bruinformula/mk11-can-sniffer-pcb/CAN_Sniffer_V2_/ECAD/CLF5030NIT-101M-D.step

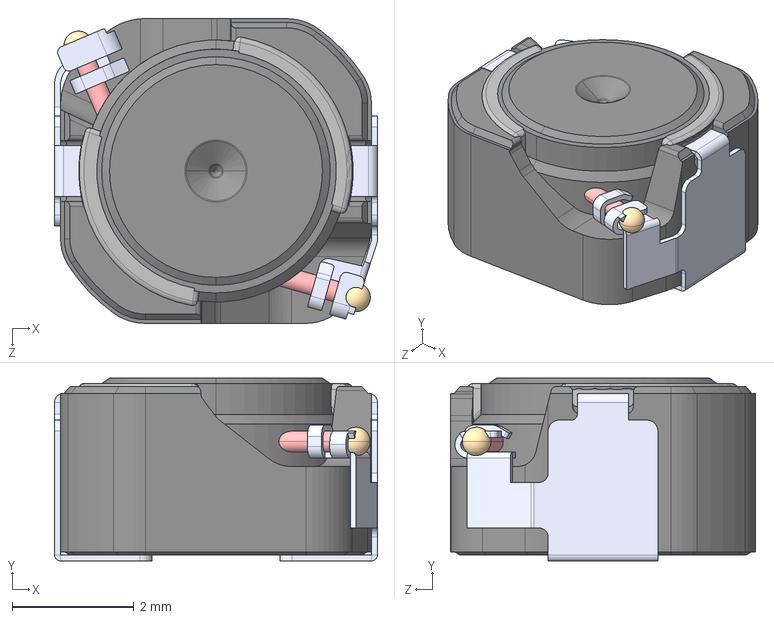
[picture p1: CAD file, 2026-01-09]
CAN_Sniffer_V2_/ECAD/CLF5030NIT-101M-D.step
5.30 x 3.00 x 5.00 mm
