bruinformula/mk11-can-sniffer-pcb/CAN_Sniffer_V2_/ECAD/DDZ13B-7.stp

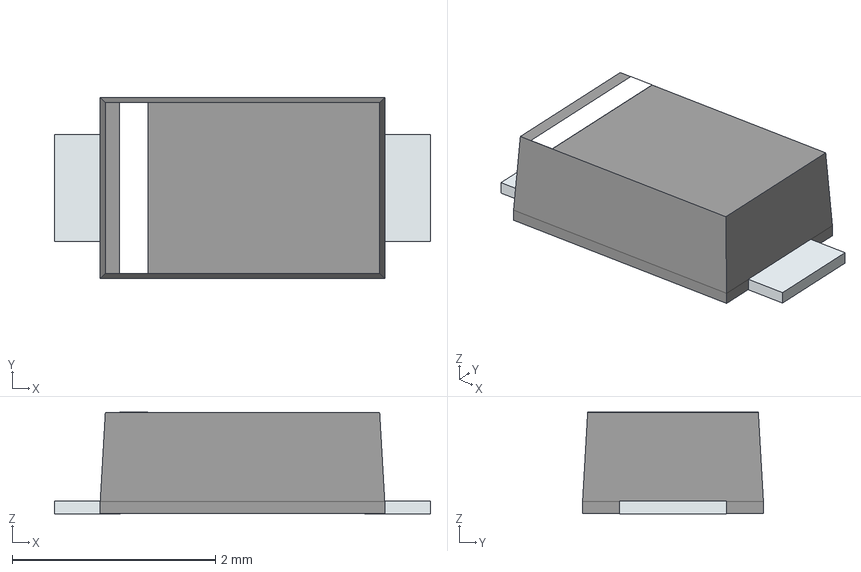
[picture p2: CAD file, 2025-09-27]
CAN_Sniffer_V2_/ECAD/DDZ13B-7.stp
3.70 x 1.78 x 1.00 mm
PinKIdent
PinK
PinA
