bruinformula/mk11-can-sniffer-pcb/CAN_Sniffer_V2_/ECAD/SQ2319CES-T1_GE3.stp

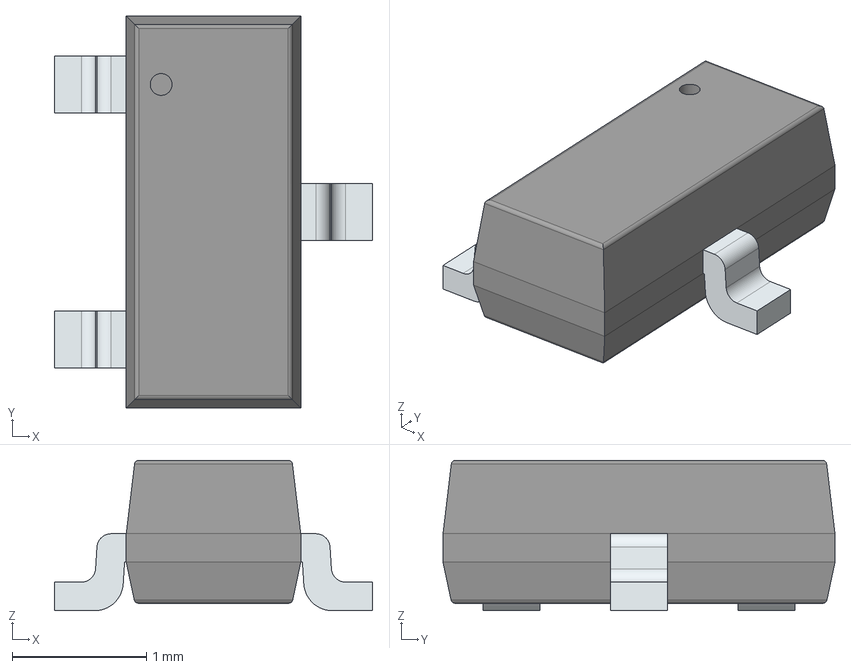
[picture p3: CAD file, 2025-09-27]
CAN_Sniffer_V2_/ECAD/SQ2319CES-T1_GE3.stp
2.37 x 2.92 x 1.12 mm
PinsArrayL
FilletPinR
