bruinformula/mk11-can-sniffer-pcb/CAN_Sniffer_V2_/ECAD/TPS2121RUXR.stp

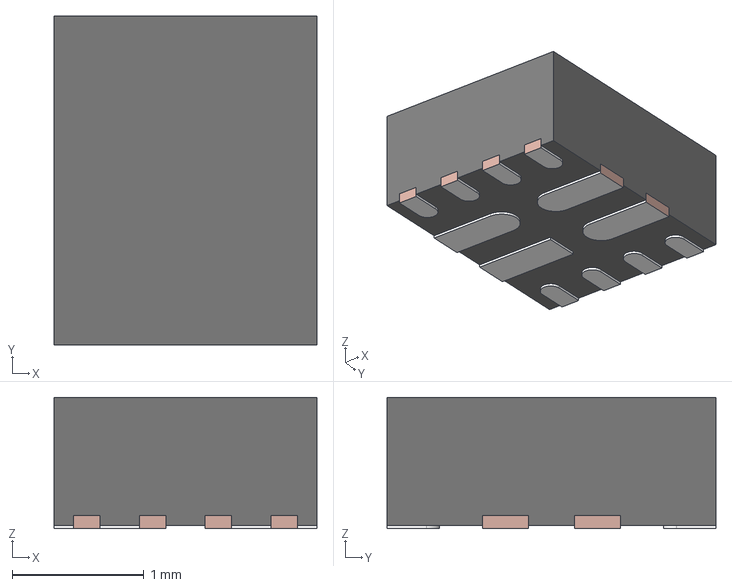
[picture p4: CAD file, 2025-09-27]
CAN_Sniffer_V2_/ECAD/TPS2121RUXR.stp
2.00 x 2.50 x 1.00 mm
FRAME
MOLD
