bruinformula/mk11-can-sniffer-pcb/CAN_Sniffer_V2_/ECAD/CLF7045NIT-330M-D.step

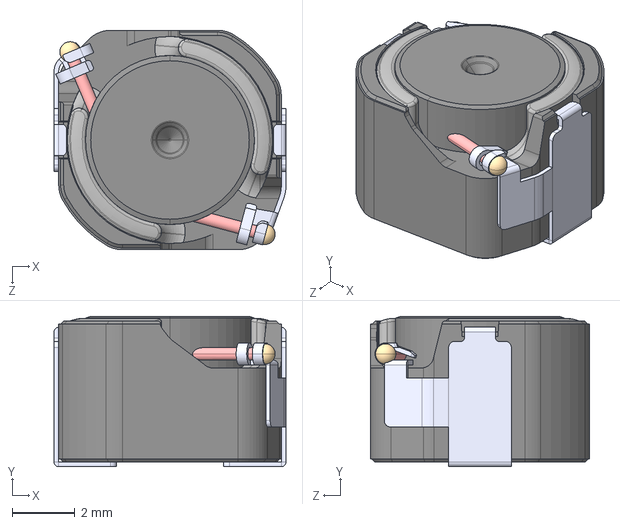
[picture p5: CAD file, 2025-09-27]
CAN_Sniffer_V2_/ECAD/CLF7045NIT-330M-D.step
7.40 x 4.80 x 7.00 mm
