bruinformula/mk11-can-sniffer-pcb/CAN_Sniffer_V2_/ECAD/PD3S230LQ-7.stp

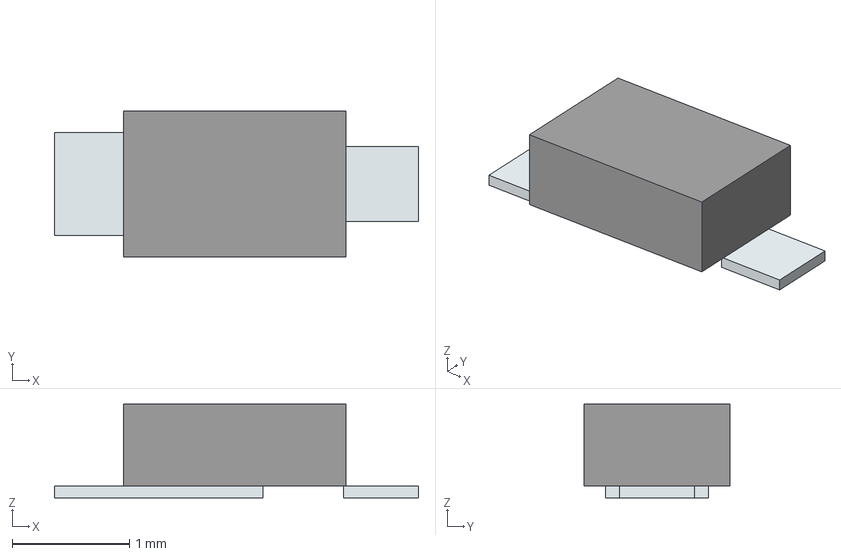
[picture p6: CAD file, 2025-09-27]
CAN_Sniffer_V2_/ECAD/PD3S230LQ-7.stp
3.11 x 1.25 x 0.8 mm
Pins
