bruinformula/mk11-can-sniffer-pcb/CAN_Sniffer_V2_/ECAD/DDA0008J.stp

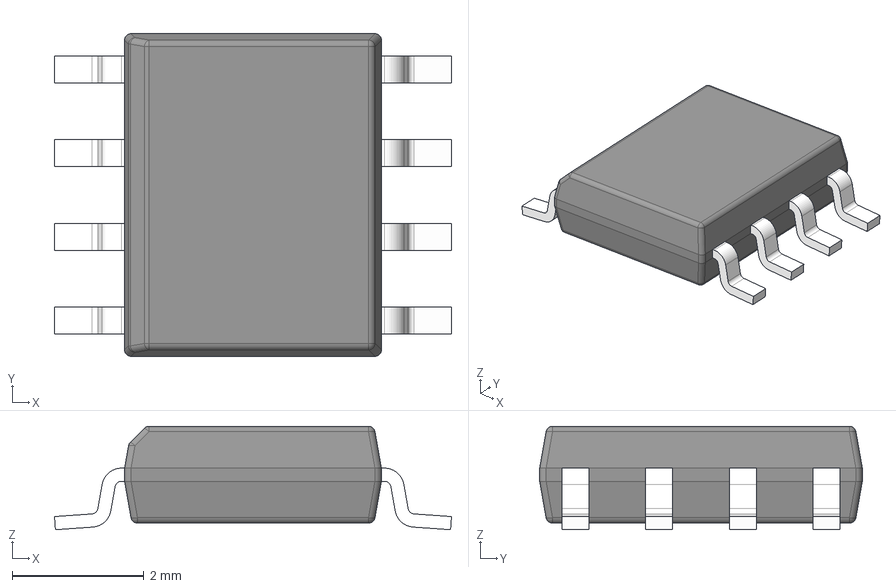
[picture p7: CAD file, 2025-09-27]
CAN_Sniffer_V2_/ECAD/DDA0008J.stp
6.03 x 4.90 x 1.57 mm
BODY-SO
LEAD-SO x 8
THERMALPAD-SO
