bruinformula/mk11-can-sniffer-pcb/CAN_Sniffer_V2_/ECAD/TPD2E001DZDR.stp

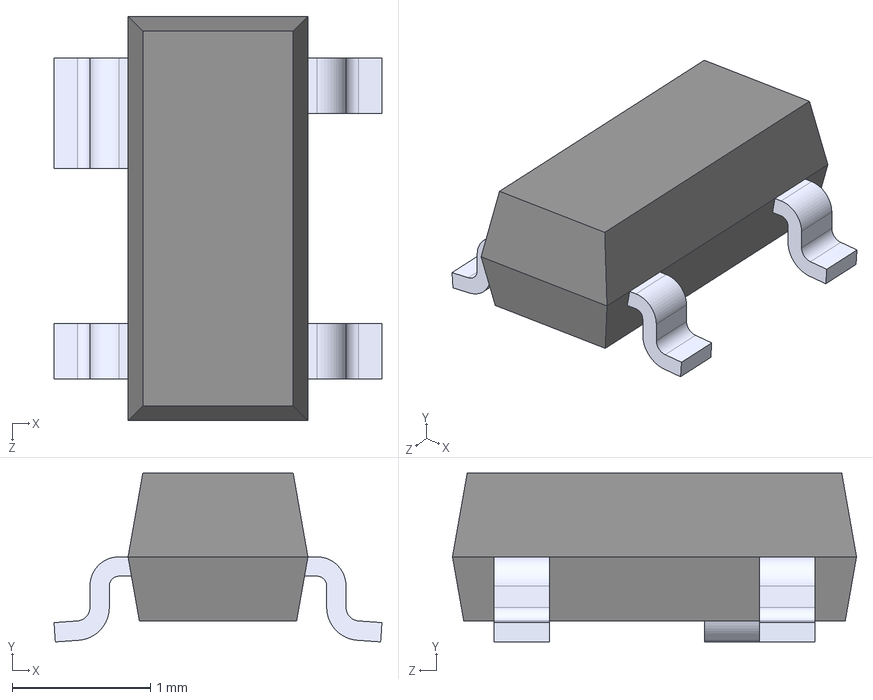
[picture p8: CAD file, 2025-09-27]
CAN_Sniffer_V2_/ECAD/TPD2E001DZDR.stp
2.37 x 1.22 x 2.92 mm
