bruinformula/mk11-can-sniffer-pcb/CAN_Sniffer_V2_/ECAD/USB1125-GF-B.stp

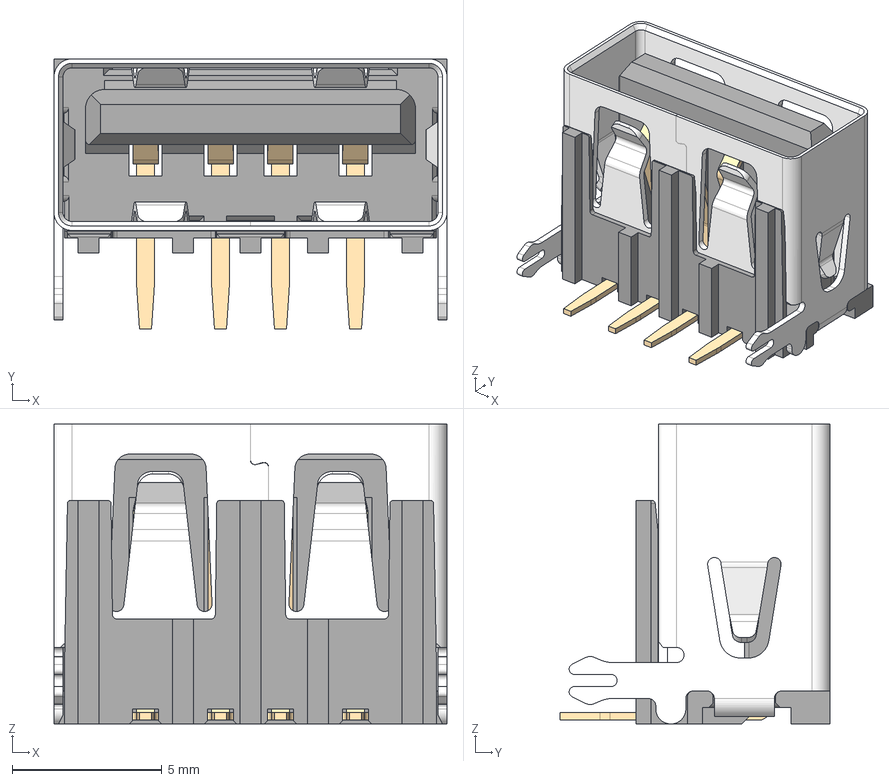
[picture p9: CAD file, 2025-09-27]
CAN_Sniffer_V2_/ECAD/USB1125-GF-B.stp
13.1 x 9.01 x 10.0 mm
USB1125-GF-B_PART1 x 4
USB1125-GF-B_PART2
USB1125-GF-B_PART3
