bruinformula/mk11-can-sniffer-pcb/CAN_Sniffer_V1/ECAD/693072010801.stp

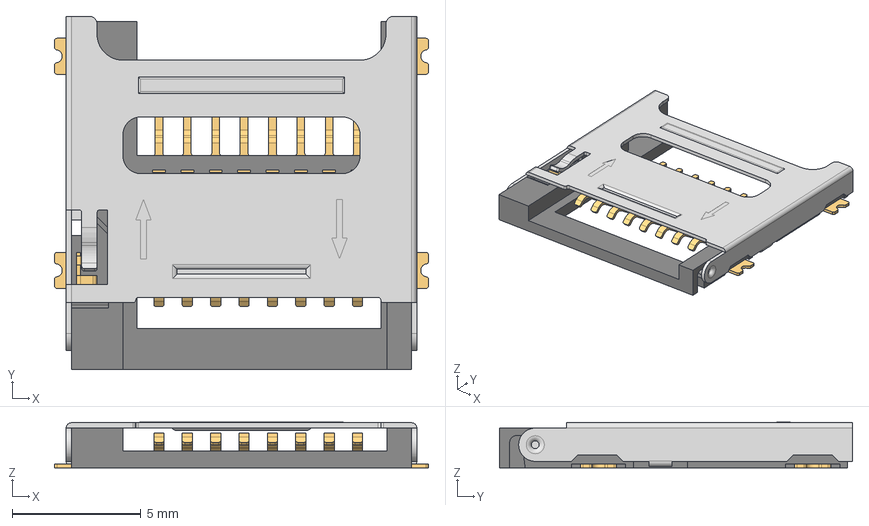
[picture p10: CAD file, 2026-01-09]
CAN_Sniffer_V1/ECAD/693072010801.stp
14.5 x 13.7 x 1.77 mm
693072010801_PIN x 8
693072010801_PATTE x 3
693072010801_CACHE
693072010801_PATTE_SPE
