bruinformula/mk11-can-sniffer-pcb/CAN_Sniffer_V1/CAN_Sniffer_1.0.kicad_pcb

## KiCad design CAN_Sniffer_V1/CAN_Sniffer_1.0.kicad_pcb (2026-01-09)

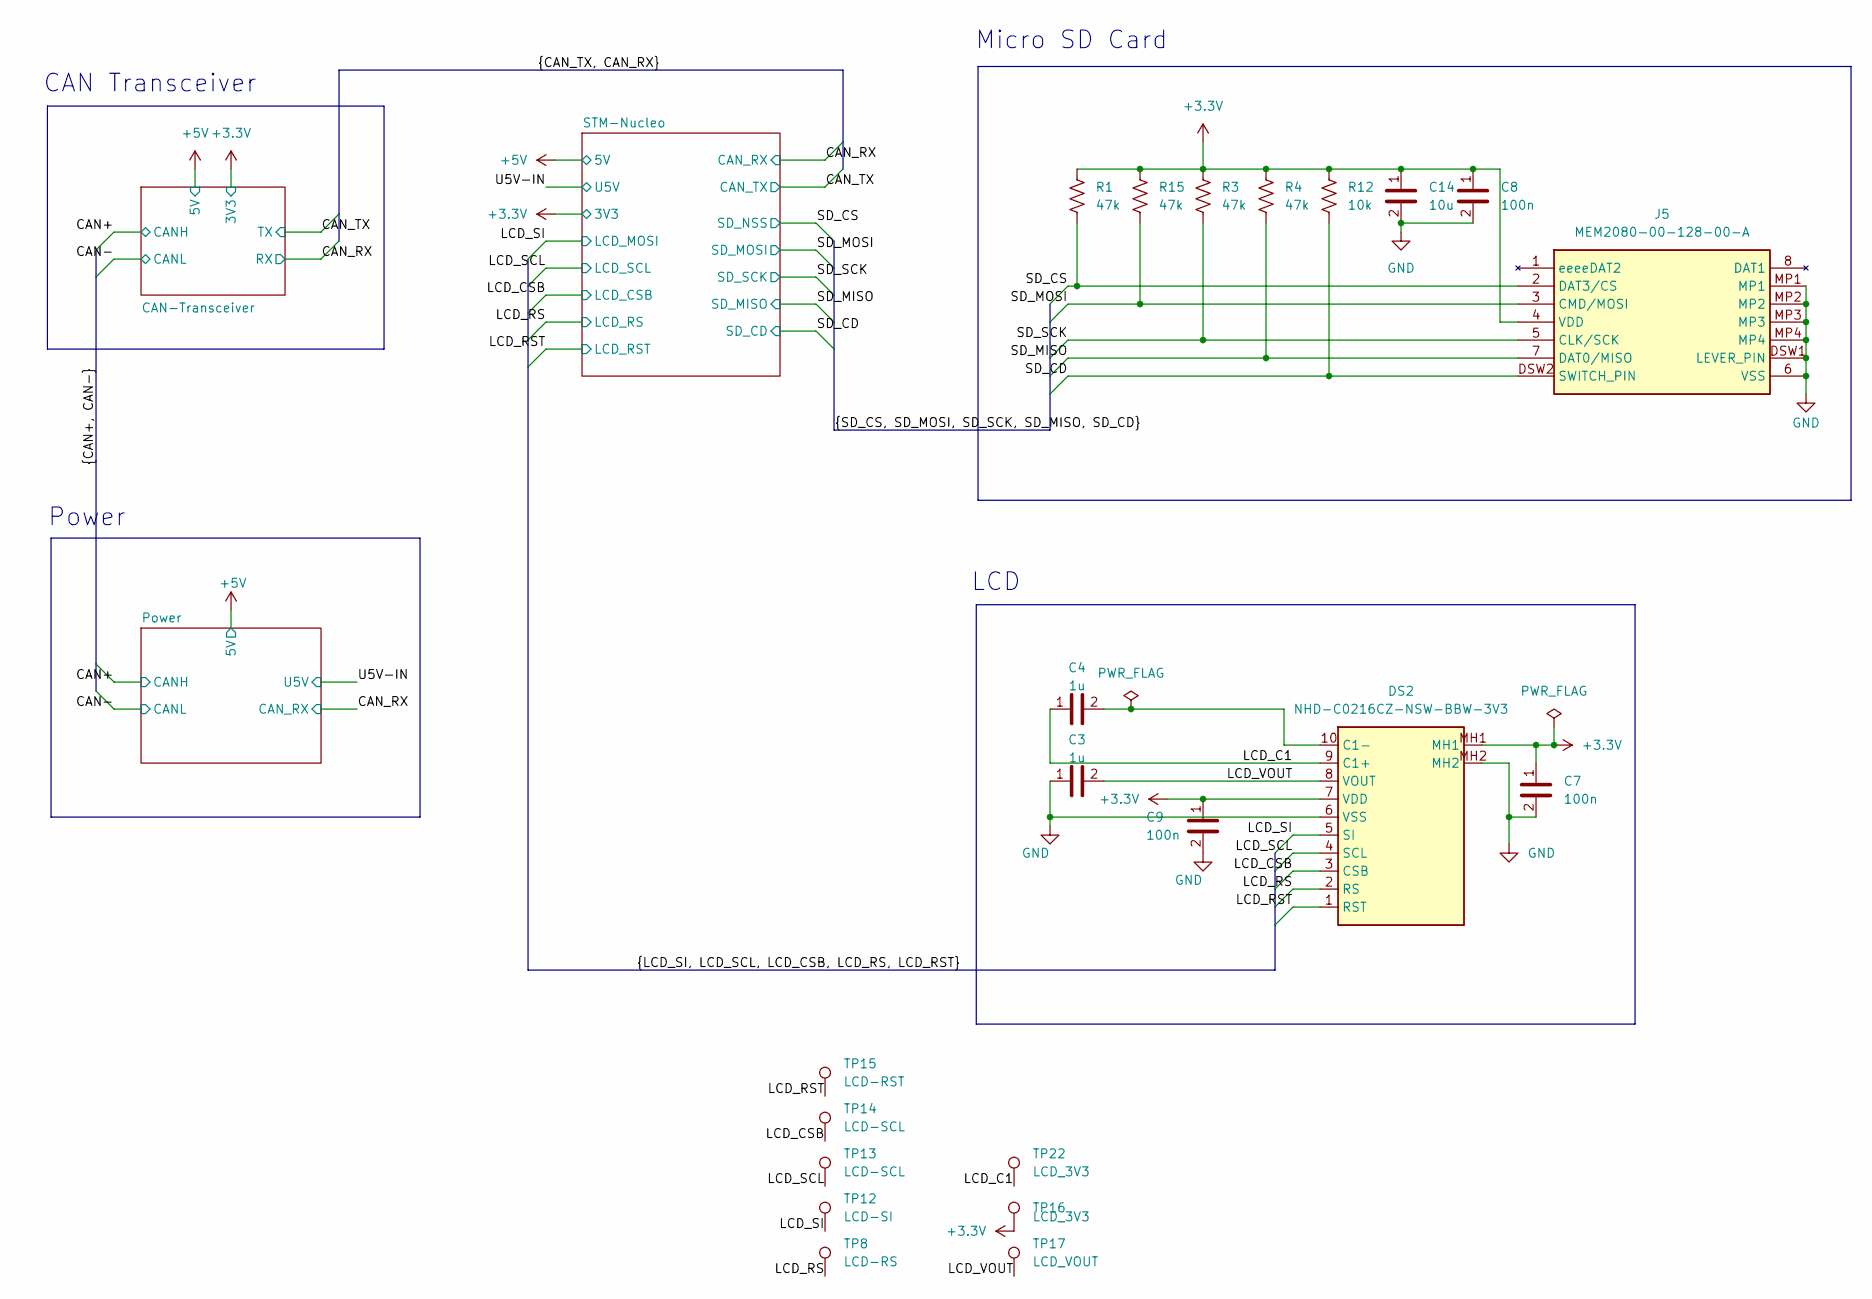
[picture p11: schematic CAN_Sniffer_1.0.kicad_sch]

Parts:
C3, C4: 1u; C_0603_1608Metric_Pad1.08x0.95mm_HandSolder; Mouser P/N 963-MAJCT168BB7105KT
C7, C8, C9: 100n; C_0603_1608Metric_Pad1.08x0.95mm_HandSolder; Mouser P/N 581-06035C104KAT2A; Digikey P/N 478-KGM15BR71H104KTCT-ND
C14: 10u; C_0603_1608Metric_Pad1.08x0.95mm_HandSolder; Mouser P/N 81-GRM188R61E106MA3D
DS2: NHD-C0216CZ-NSW-BBW-3V3; NHDC0216CZNSWBBW3V3; Mouser Part Number 763-C0216CZ-NSWBBW3V
J5: MEM2080-00-128-00-A; MEM20800012800A; Mouser Part Number 640-MEM2080-0012800A
R1, R3, R4, R15: 47k; R_0603_1608Metric_Pad0.98x0.95mm_HandSolder; Mouser P/N 708-RMCF0603FT47K0; Digikey P/N RMCF0603FT47K0CT-ND
R12: 10k; R_0603_1608Metric_Pad0.98x0.95mm_HandSolder; Mouser P/N 708-RMCF0603FT10K0; Digikey P/N RMCF0603FT10K0CT-ND
TP8: LCD-RS; TestPoint_Pad_D1.0mm
TP12: LCD-SI; TestPoint_Pad_D1.0mm
TP13, TP14: LCD-SCL; TestPoint_Pad_D1.0mm
TP15: LCD-RST; TestPoint_Pad_D1.0mm
TP16, TP22: LCD_3V3; TestPoint_Pad_D1.0mm
TP17: LCD_VOUT; TestPoint_Pad_D1.0mm

Connections:
+3.3V: C7.1, C8.1, C9.1, C14.1, DS2.7 (VDD), DS2.MH1, J5.4 (VDD), R1.2, R3.2, R4.2, R12.2, R15.2, TP16.1; also elsewhere on the board
/LCD_C1: C4.1, DS2.9 (C1+), TP22.1
/LCD_CSB: DS2.3 (CSB), TP14.1; also elsewhere on the board
/LCD_RS: DS2.2 (RS), TP8.1; also elsewhere on the board
/LCD_RST: DS2.1 (RST), TP15.1; also elsewhere on the board
/LCD_SCL: DS2.4 (SCL), TP13.1; also elsewhere on the board
/LCD_SI: DS2.5 (SI), TP12.1; also elsewhere on the board
/LCD_VOUT: C3.2, DS2.8 (VOUT), TP17.1
/SD_CD: J5.DSW2 (SWITCH_PIN), R12.1; also elsewhere on the board
/SD_CS: J5.2 (DAT3/CS), R1.1; also elsewhere on the board
/SD_MISO: J5.7 (DAT0/MISO), R4.1; also elsewhere on the board
/SD_MOSI: J5.3 (CMD/MOSI), R15.1; also elsewhere on the board
/SD_SCK: J5.5 (CLK/SCK), R3.1; also elsewhere on the board
GND: C3.1, C7.2, C8.2, C9.2, C14.2, DS2.6 (VSS), DS2.MH2, J5.6 (VSS), J5.DSW1 (LEVER_PIN), J5.MP1, J5.MP2, J5.MP3, J5.MP4; also elsewhere on the board
unnamed: C4.2, DS2.10 (C1-)

Notes on the sheet:
LCD
Power
Micro SD Card
CAN Transceiver

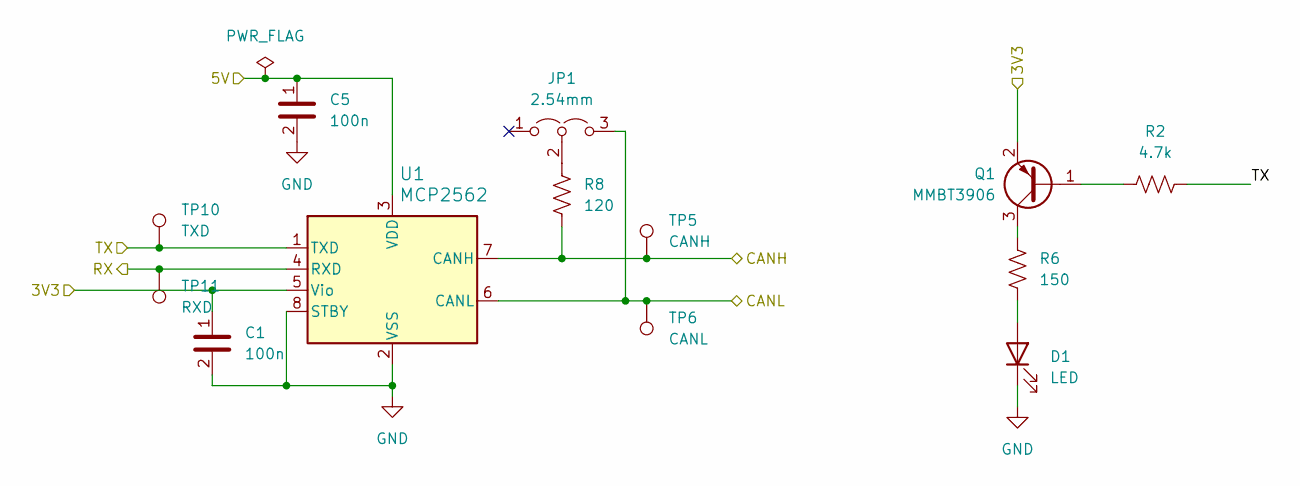
[picture p12: schematic CAN_transceiver1.kicad_sch]

Parts:
C1, C5: 100n; C_0805_2012Metric_Pad1.18x1.45mm_HandSolder; Mouser P/N 581-08051C104KAT4A
D1: LED; LED_0805_2012Metric_Pad1.15x1.40mm_HandSolder
JP1: 2.54mm; PinHeader_1x03_P2.54mm_Vertical; Mouser P/N 855-M7581-46; Digikey P/N S9337-ND
Q1: MMBT3906; SOT-23
R2: 4.7k; R_0603_1608Metric_Pad0.98x0.95mm_HandSolder; Mouser P/N 708-RMCF0603FT4K70; Digikey P/N RMCF0603FT4K70CT-ND
R6: 150; R_0603_1608Metric_Pad0.98x0.95mm_HandSolder; Mouser P/N 708-RMCF0603FT150R; Digikey P/N RMCF0603FT150RCT-ND
R8: 120; R_0402_1005Metric_Pad0.72x0.64mm_HandSolder; Mouser P/N 708-RMCF0402FT120R; Digikey P/N RMCF0402FT120RCT-ND
TP5: CANH; TestPoint_Pad_D1.0mm
TP6: CANL; TestPoint_Pad_D1.0mm
TP10: TXD; TestPoint_Pad_D1.0mm
TP11: RXD; TestPoint_Pad_D1.0mm
U1: MCP2562; SOIC-8_3.9x4.9mm_P1.27mm; Digikey PN MCP2562FDT-E/SNCT-ND

Connections:
+3.3V: C1.1, Q1.2 (E), U1.5 (Vio); also elsewhere on the board
+5V: C5.1, U1.3 (VDD); also elsewhere on the board
/CAN+: R8.1, TP5.1, U1.7 (CANH); also elsewhere on the board
/CAN-: JP1.3 (B), TP6.1, U1.6 (CANL); also elsewhere on the board
/CAN_RX: TP11.1, U1.4 (RXD); also elsewhere on the board
/CAN_TX: R2.2, TP10.1, U1.1 (TXD); also elsewhere on the board
GND: C1.2, C5.2, D1.1 (K), U1.2 (VSS), U1.8 (STBY); also elsewhere on the board
unnamed: D1.2 (A), R6.1
unnamed: JP1.2 (C), R8.2
unnamed: Q1.1 (B), R2.1
unnamed: Q1.3 (C), R6.2

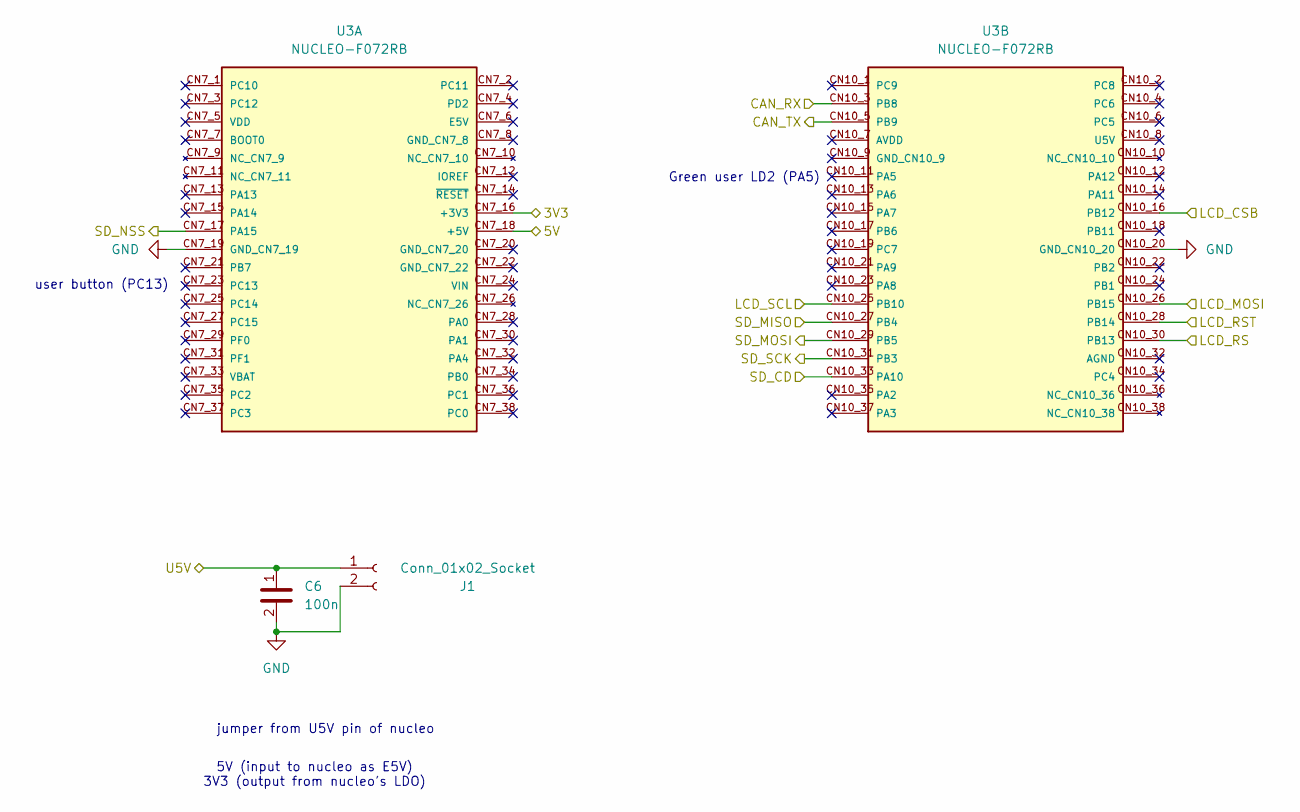
[picture p13: schematic STM32-Nucleo.kicad_sch]

Parts:
C6: 100n; C_0805_2012Metric_Pad1.18x1.45mm_HandSolder; Mouser P/N 581-08051C104KAT4A
J1: Conn_01x02_Socket; PinHeader_1x02_P2.54mm_Vertical
U3: NUCLEO-F072RB; MODULE_NUCLEO-F072RB; PARTREV 17

Connections:
+3.3V: U3.CN7_16 (+3V3); also elsewhere on the board
+5V: U3.CN7_18 (+5V); also elsewhere on the board
/CAN_RX: U3.CN10_3 (PB8); also elsewhere on the board
/CAN_TX: U3.CN10_5 (PB9); also elsewhere on the board
/LCD_CSB: U3.CN10_16 (PB12); also elsewhere on the board
/LCD_RS: U3.CN10_30 (PB13); also elsewhere on the board
/LCD_RST: U3.CN10_28 (PB14); also elsewhere on the board
/LCD_SCL: U3.CN10_25 (PB10); also elsewhere on the board
/LCD_SI: U3.CN10_26 (PB15); also elsewhere on the board
/SD_CD: U3.CN10_33 (PA10); also elsewhere on the board
/SD_CS: U3.CN7_17 (PA15); also elsewhere on the board
/SD_MISO: U3.CN10_27 (PB4); also elsewhere on the board
/SD_MOSI: U3.CN10_29 (PB5); also elsewhere on the board
/SD_SCK: U3.CN10_31 (PB3); also elsewhere on the board
/U5V-IN: C6.1, J1.1; also elsewhere on the board
GND: C6.2, J1.2, U3.CN7_19 (GND_CN7_19), U3.CN10_20 (GND_CN10_20); also elsewhere on the board

Notes on the sheet:
user button (PC13)
Green user LD2 (PA5)
jumper from U5V pin of nucleo
5V (input to nucleo as E5V) 3V3 (output from nucleo's LDO)

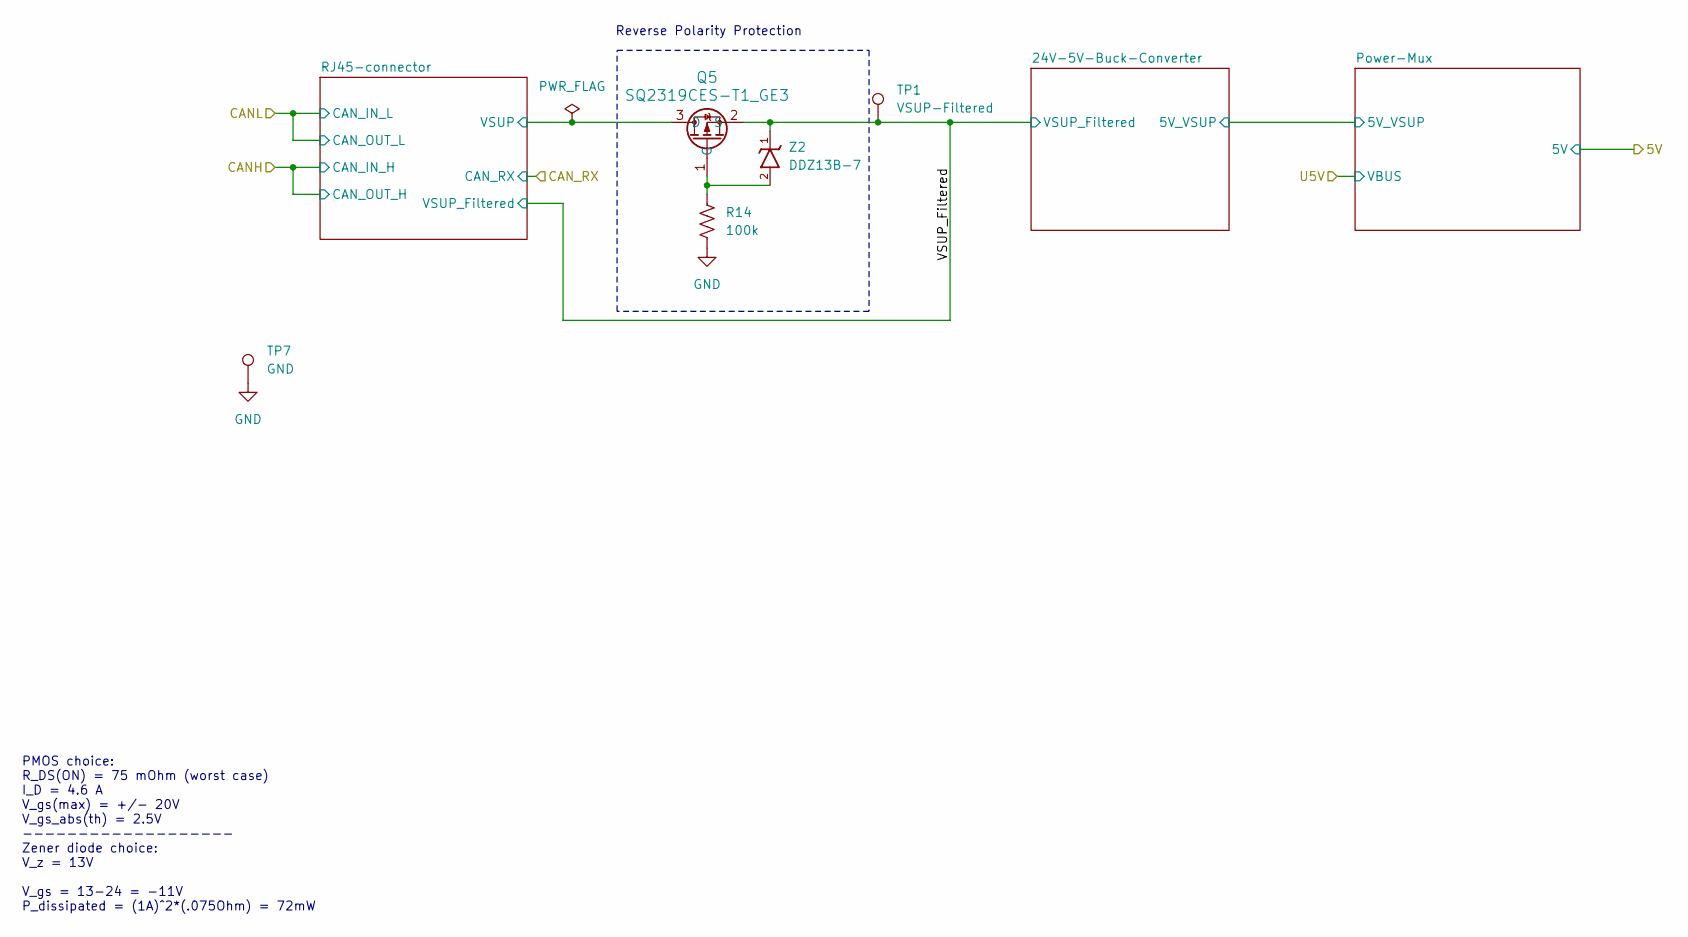
[picture p14: schematic Power.kicad_sch]

Parts:
Q5: SQ2319CES-T1_GE3; PMOSGSD_SOT-23_TO-236_VIS
R14: 100k; R_0603_1608Metric_Pad0.98x0.95mm_HandSolder; Mouser P/N 708-RMCF0603FT100K; Digikey P/N RMCF0603FT100KCT-ND
TP1: VSUP-Filtered; TestPoint_Pad_D1.0mm
TP7: GND; TestPoint_Keystone_5015_Micro_Mini
Z2: DDZ13B-7; SOD3716X145N; Mouser Part Number 621-DDZ13B-7

Connections:
/Power/RJ45-connector/VSUP: Q5.3 (D); also elsewhere on the board
/Power/VSUP_Filtered: Q5.2 (S), TP1.1, Z2.1 (K); also elsewhere on the board
GND: R14.1, TP7.1; also elsewhere on the board
unnamed: Q5.1 (G), R14.2, Z2.2 (A)

Notes on the sheet:
PMOS choice: R_DS(ON) = 75 mOhm (worst case) I_D = 4.6 A V_gs(max) = +/- 20V V_gs_abs(th) = 2.5V ------------------- Zener diode choice: V_z = 13V V_gs = 13-24 = -11V P_dissipated = (1A)^2*(.075Ohm) = 72mW
Reverse Polarity Protection

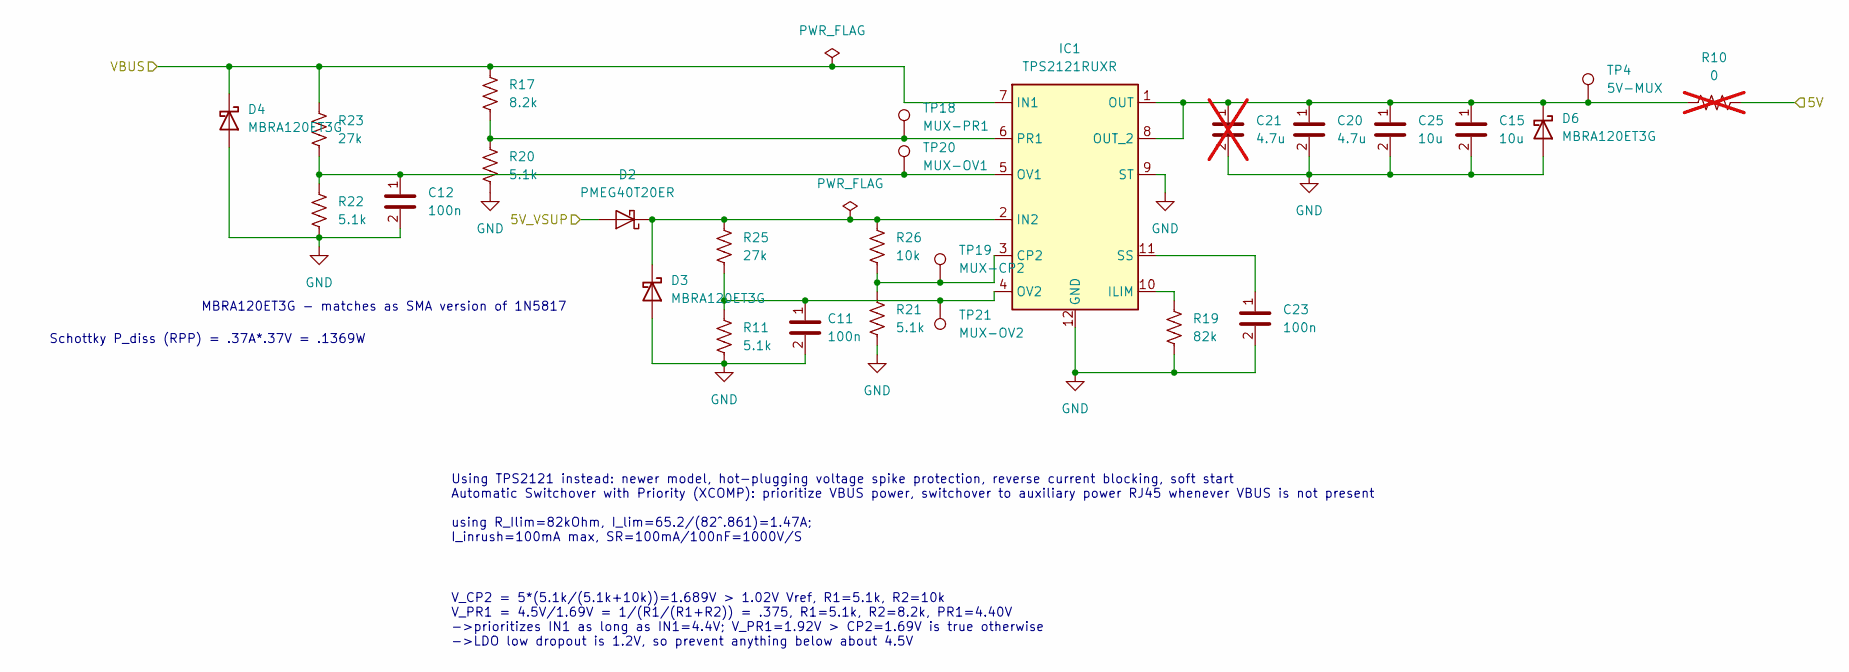
[picture p15: schematic power-mux.kicad_sch]

Parts:
C11, C12: 100n; C_0402_1005Metric_Pad0.74x0.62mm_HandSolder; LCSC P/N C307331
C15, C25: 10u; C_0603_1608Metric_Pad1.08x0.95mm_HandSolder; Mouser P/N 81-GRM188R61E106MA3D
C20: 4.7u; C_0603_1608Metric_Pad1.08x0.95mm_HandSolder; LCSC P/N C19666
C21: 4.7u; C_0603_1608Metric_Pad1.08x0.95mm_HandSolder; LCSC P/N C19666; not fitted
C23: 100n; C_0603_1608Metric_Pad1.08x0.95mm_HandSolder; Mouser P/N 581-06035C104KAT2A; Digikey P/N 478-KGM15BR71H104KTCT-ND
D2: PMEG40T20ER; Nexperia_CFP3_SOD-123W
D3, D4, D6: MBRA120ET3G; D_SMA_Handsoldering; Mouser PN MBRA120ET3G
IC1: TPS2121RUXR; Mouser Part Number 595-TPS2121RUXR
R10: 0; R_0805_2012Metric_Pad1.20x1.40mm_HandSolder; Mouser P/N 708-RMCF0805ZT0R00; Digikey P/N RMCF0805ZT0R00CT-ND; not fitted
R11, R20, R21, R22: 5.1k; R_0603_1608Metric_Pad0.98x0.95mm_HandSolder; Mouser P/N 708-RMCF0603FT5K10; Digikey P/N RMCF0603FT5K10CT-ND
R17: 8.2k; R_0603_1608Metric_Pad0.98x0.95mm_HandSolder; Mouser P/N 708-RMCF0603FT8K20; Digikey P/N RMCF0603FT8K20CT-ND
R19: 82k; R_0603_1608Metric_Pad0.98x0.95mm_HandSolder; Mouser P/N 708-RMCF0603FT82K0; Digikey P/N RMCF0603FT82K0CT-ND
R23, R25: 27k; R_0603_1608Metric_Pad0.98x0.95mm_HandSolder; Mouser P/N 708-RMCF0603FT27K0; Digikey P/N RMCF0603FT27K0CT-ND
R26: 10k; R_0603_1608Metric_Pad0.98x0.95mm_HandSolder; Mouser P/N 708-RMCF0603FT10K0; Digikey P/N RMCF0603FT10K0CT-ND
TP4: 5V-MUX; TestPoint_Pad_D1.0mm
TP18: MUX-PR1; TestPoint_Pad_D1.0mm
TP19: MUX-CP2; TestPoint_Pad_D1.0mm
TP20: MUX-OV1; TestPoint_Pad_D1.0mm
TP21: MUX-OV2; TestPoint_Pad_D1.0mm

Connections:
+5V: R10.2; also elsewhere on the board
/U5V-IN: D2.2 (A); also elsewhere on the board
GND: C11.2, C12.2, C15.2, C20.2, C21.2, C23.2, C25.2, D3.2 (A), D4.2 (A), D6.2 (A), IC1.9 (ST), IC1.12 (GND), R11.1, R19.1, R20.1, R21.1, R22.1; also elsewhere on the board
unnamed: C15.1, C20.1, C21.1, C25.1, D6.1 (K), IC1.1 (OUT), IC1.8 (OUT_2), R10.1, TP4.1
unnamed: IC1.3 (CP2), R21.2, R26.1, TP19.1
unnamed: IC1.10 (ILIM), R19.2
unnamed: C12.1, IC1.5 (OV1), R22.2, R23.1, TP20.1
unnamed: C11.1, IC1.4 (OV2), R11.2, R25.1, TP21.1
unnamed: IC1.6 (PR1), R17.1, R20.2, TP18.1
unnamed: C23.1, IC1.11 (SS)

Notes on the sheet:
V_CP2 = 5*(5.1k/(5.1k+10k))=1.689V > 1.02V Vref, R1=5.1k, R2=10k V_PR1 = 4.5V/1.69V = 1/(R1/(R1+R2)) = .375, R1=5.1k, R2=8.2k, PR1=4.40V ->prioritizes IN1 as long as IN1=4.4V; V_PR1=1.92V > CP2=1.69V is true otherwise ->LDO low dropout is 1.2V, so prevent anything below about 4.5V
MBRA120ET3G - matches as SMA version of 1N5817
Using TPS2121 instead: newer model, hot-plugging voltage spike protection, reverse current blocking, soft start Automatic Switchover with Priority (XCOMP): prioritize VBUS power, switchover to auxiliary power RJ45 whenever VBUS is not present using R_Ilim=82kOhm, I_lim=65.2/(82^.861)=1.47A; I_inrus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
Schottky P_diss (RPP) = .37A*.37V = .1369W

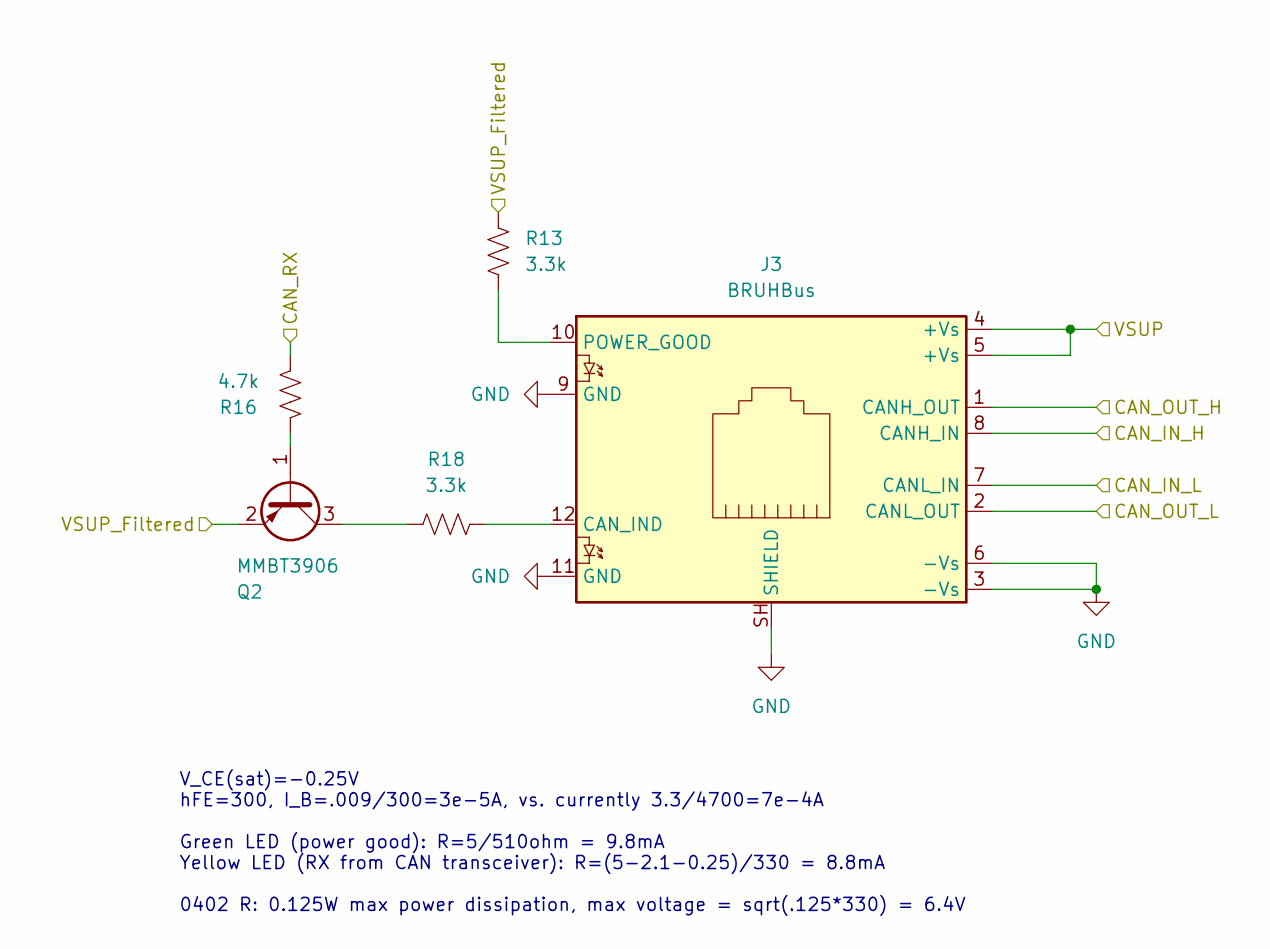
[picture p16: schematic RJ45-connector.kicad_sch]

Parts:
J3: BRUHBus; RJ45_Amphenol_RJHSE538X; Manufacturer P/N MTJ-88ARX1-FSM-LG; Digikey P/N 2057-MTJ-88ARX1-FSM-LG-ND
Q2: MMBT3906; SOT-23
R13, R18: 3.3k; R_0603_1608Metric_Pad0.98x0.95mm_HandSolder; Mouser P/N 708-RMCF0603FT3K30; Digikey P/N RMCF0603FT3K30CT-ND
R16: 4.7k; R_0603_1608Metric_Pad0.98x0.95mm_HandSolder; Mouser P/N 708-RMCF0603FT4K70; Digikey P/N RMCF0603FT4K70CT-ND

Connections:
/CAN+: J3.1 (CANH_OUT), J3.8 (CANH_IN); also elsewhere on the board
/CAN-: J3.2 (CANL_OUT), J3.7 (CANL_IN); also elsewhere on the board
/CAN_RX: R16.1; also elsewhere on the board
/Power/RJ45-connector/VSUP: J3.4 (+Vs), J3.5 (+Vs); also elsewhere on the board
/Power/VSUP_Filtered: Q2.2 (E), R13.2; also elsewhere on the board
GND: J3.3 (-Vs), J3.6 (-Vs), J3.9 (GND), J3.11 (GND), J3.SH (SHIELD); also elsewhere on the board
unnamed: J3.12 (CAN_IND), R18.1
unnamed: J3.10 (POWER_GOOD), R13.1
unnamed: Q2.1 (B), R16.2
unnamed: Q2.3 (C), R18.2

Notes on the sheet:
V_CE(sat)=-0.25V hFE=300, I_B=.009/300=3e-5A, vs. currently 3.3/4700=7e-4A Green LED (power good): R=5/510ohm = 9.8mA Yellow LED (RX from CAN transceiver): R=(5-2.1-0.25)/330 = 8.8mA 0402 R: 0.125W max power dissipation, max voltage = sqrt(.125*330) = 6.4V

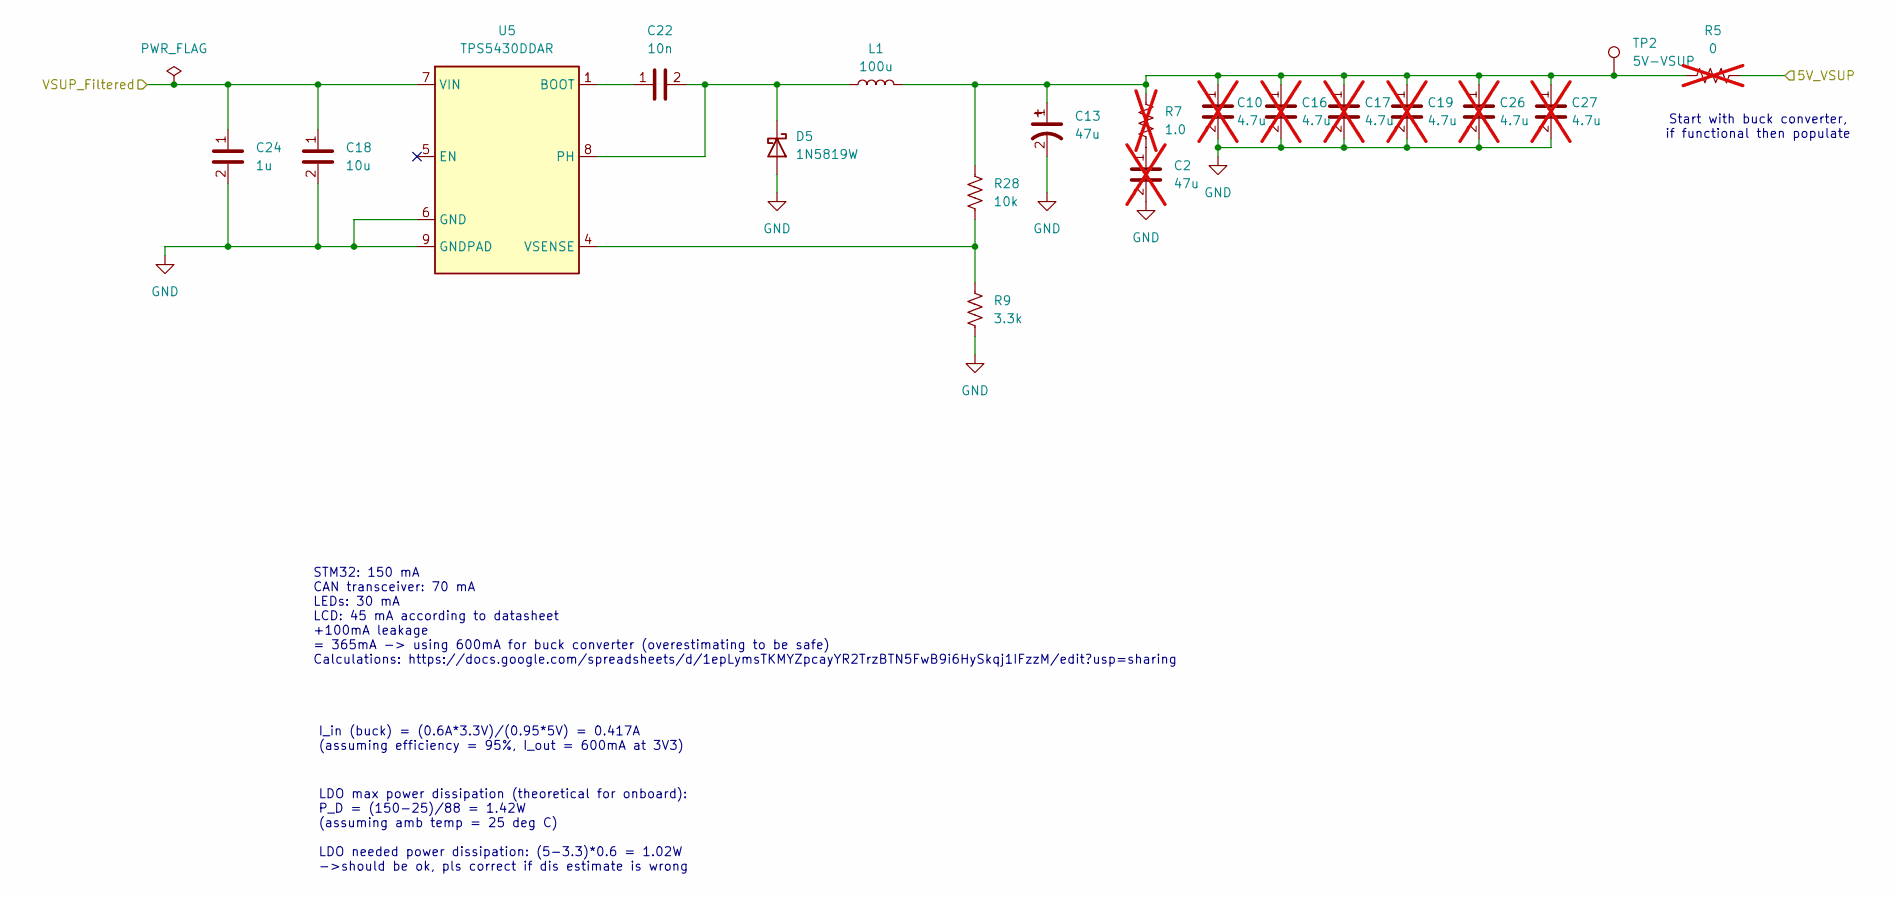
[picture p17: schematic 5V-Buck.kicad_sch]

Parts:
C2: 47u; C_0805_2012Metric_Pad1.18x1.45mm_HandSolder; LCSC P/N C16780; not fitted
C10, C16, C17, C19, C26, C27: 4.7u; C_0805_2012Metric_Pad1.18x1.45mm_HandSolder; Mouser P/N 581-KGM21AR51A475KU; Digikey P/N 478-KGM21AR51A475KUCT-ND; not fitted
C13: 47u; CP_Radial_D5.0mm_P2.00mm; Mouser P/N 80-EST476M025AC3AA; Digikey P/N 399-6618-ND
C18: 10u; C_0603_1608Metric_Pad1.08x0.95mm_HandSolder; Mouser P/N 81-GRM188R61E106MA3D
C22: 10n; C_0805_2012Metric_Pad1.18x1.45mm_HandSolder; Mouser P/N 581-08055A103JAT2A; Digikey P/N 478-KGM21ACG1H103JUCT-ND
C24: 1u; C_0603_1608Metric_Pad1.08x0.95mm_HandSolder; LCSC P/N C15849
D5: 1N5819W; D_SOD-323_HandSoldering; Mouser P/N 833-B5819WS-TP; LCSC P/N C191023
L1: 100u; CLF5030NI-D; Mouser P/N 810-CLF5030NIT101MD
R5: 0; R_0805_2012Metric_Pad1.20x1.40mm_HandSolder; Mouser P/N 708-RMCF0805ZT0R00; Digikey P/N RMCF0805ZT0R00CT-ND; not fitted
R7: 1.0; R_0805_2012Metric_Pad1.20x1.40mm_HandSolder; Mouser P/N 708-RMCF0805FT1R00; Digikey P/N RMCF0805FT1R00CT-ND; not fitted
R9: 3.3k; R_0805_2012Metric_Pad1.20x1.40mm_HandSolder; Mouser P/N 708-RMCF0805FT3K30; Digikey P/N RMCF0805FT3K30CT-ND
R28: 10k; R_0805_2012Metric_Pad1.20x1.40mm_HandSolder; Mouser P/N 708-RMCF0805FT10K0; Digikey P/N RMCF0805FT10K0CT-ND
TP2: 5V-VSUP; TestPoint_Pad_D1.0mm
U5: TPS5430DDAR; TI_SO-PowerPAD-8_ThermalVias; Mouser P/N 595-TPS5430DDAR; Digikey P/N 296-26988-1-ND

Connections:
/Power/VSUP_Filtered: C18.1, C24.1, U5.7 (VIN); also elsewhere on the board
GND: C2.2, C10.2, C13.2, C16.2, C17.2, C18.2, C19.2, C24.2, C26.2, C27.2, D5.2 (A), R9.1, U5.6 (GND), U5.9 (GNDPAD); also elsewhere on the board
unnamed: C2.1, R7.1
unnamed: C10.1, C13.1, C16.1, C17.1, C19.1, C26.1, C27.1, L1.2, R5.1, R7.2, R28.2, TP2.1
unnamed: C22.2, D5.1 (K), L1.1, U5.8 (PH)
unnamed: C22.1, U5.1 (BOOT)
unnamed: R9.2, R28.1, U5.4 (VSENSE)

Notes on the sheet:
LDO max power dissipation (theoretical for onboard): P_D = (150-25)/88 = 1.42W (assuming amb temp = 25 deg C) LDO needed power dissipation: (5-3.3)*0.6 = 1.02W ->should be ok, pls correct if dis estimate is wrong
STM32: 150 mA CAN transceiver: 70 mA LEDs: 30 mA LCD: 45 mA according to datasheet +100mA leakage = 365mA -> using 600mA for buck converter (overestimating to be safe) Calculations: https://docs.google.com/spreadsheets/d/1epLymsTKMYZpcayYR2TrzBTN5FwB9i6HySkqj1IFzzM/edit?usp=sharing
I_in (buck) = (0.6A*3.3V)/(0.95*5V) = 0.417A (assuming efficiency = 95%, I_out = 600mA at 3V3)
Start with buck converter, if functional then populate

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
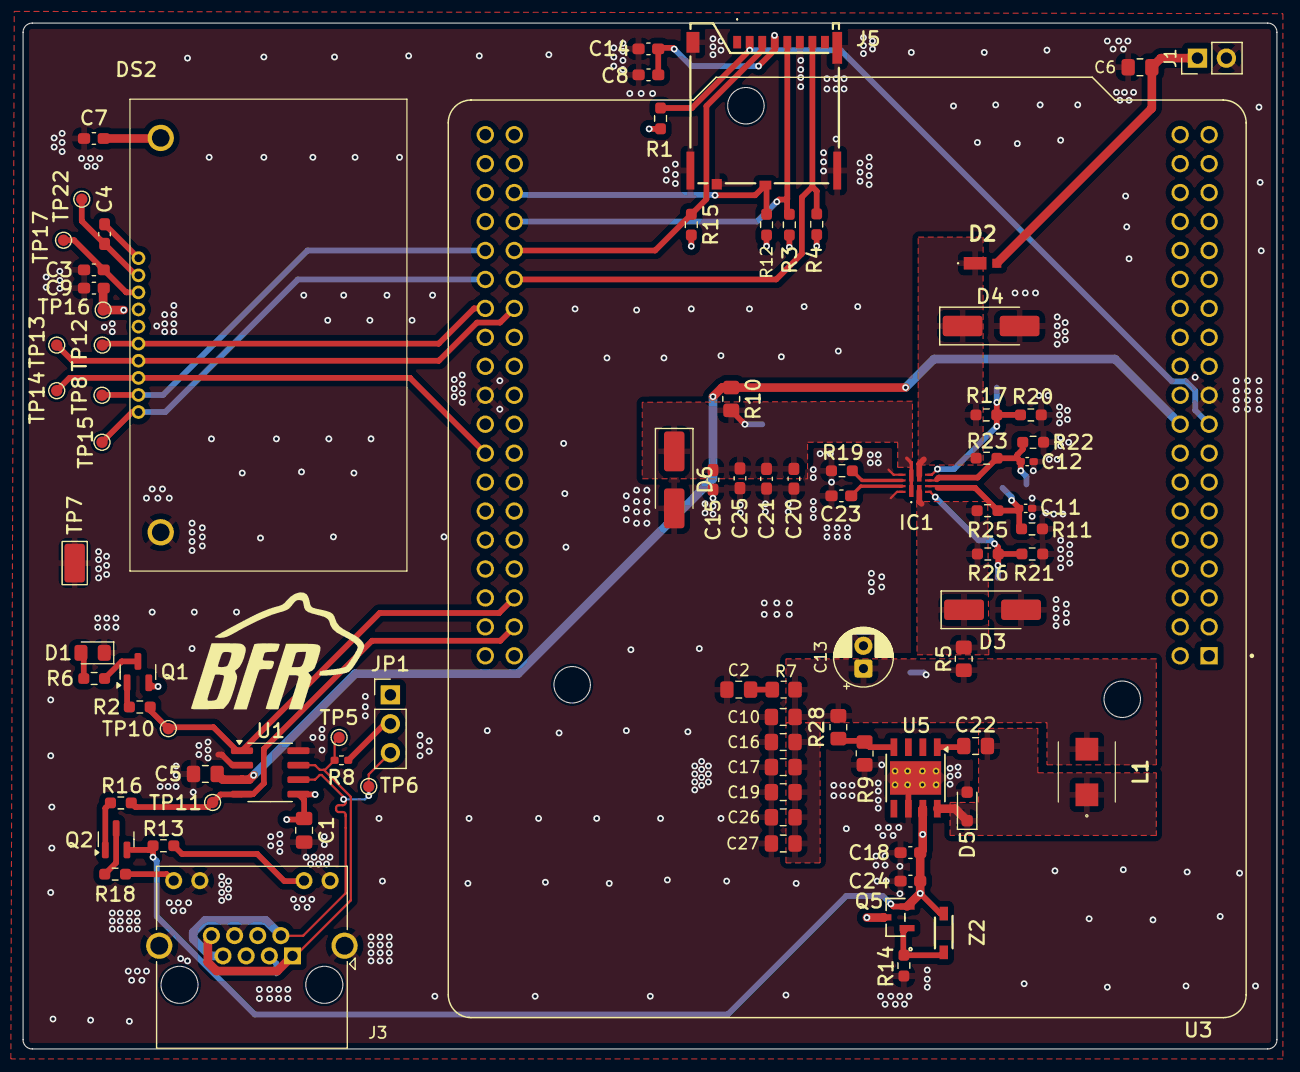
[picture p18: board CAN_Sniffer_1.0.kicad_pcb from above]

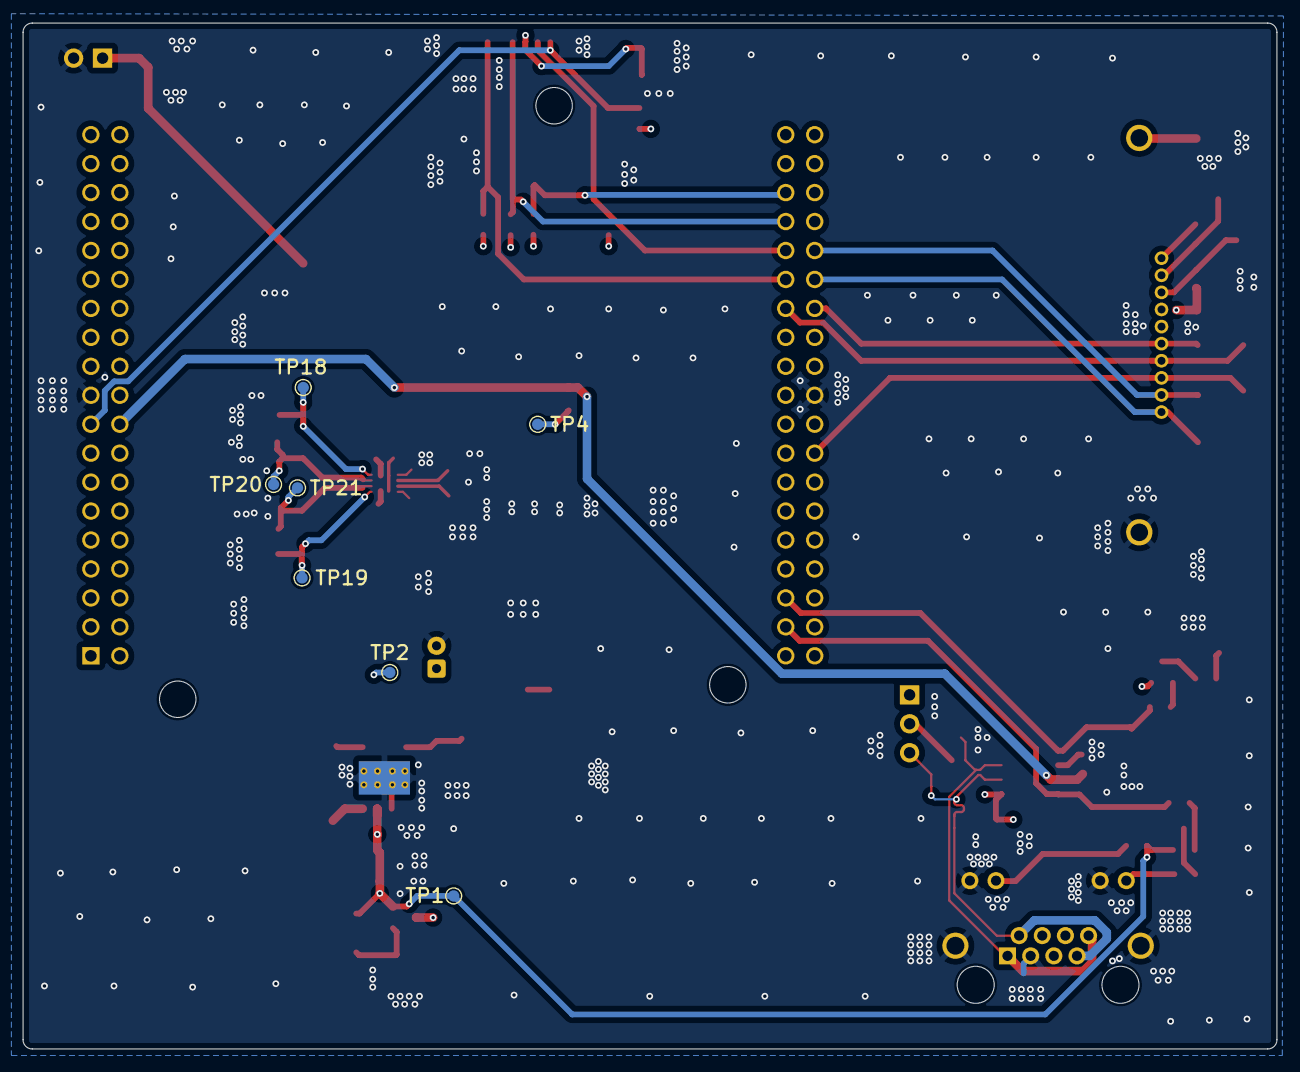
[picture p19: board CAN_Sniffer_1.0.kicad_pcb from below]

Board: 4 copper layers, 110.0 x 90.0 mm, 93 parts (7 on the bottom side), 46 nets.
