bruinformula/mk11-can-sniffer-pcb/(commit log)

2025-07-21 Initial commit: CAN transceivers and LDO
    [CAN_Sniffer_1.0.kicad_pcb, CAN_Sniffer_1.0.kicad_sch, CAN_transceiver1.kicad_sch, CAN_transceiver2.kicad_sch, STM32F446RE.kicad_sch]
2025-08-03 changed power schematics and STM32, added MicroSD card connector and LCD display
    [CAN_Sniffer_1.0.kicad_sch, CAN_transceiver1.kicad_sch, CAN_transceiver2.kicad_sch, STM32-Nucleo.kicad_sch, STM32F446RE.kicad_sch]
2025-08-20 changed power schem, pinouts, first iteration layout
    [5V-Buck.kicad_sch, CAN_Sniffer_1.0.kicad_pcb, CAN_Sniffer_1.0.kicad_sch, CAN_transceiver1.kicad_sch, Power.kicad_sch, RJ45-connector.kicad_sch, RVP.kicad_sch, STM32-Nucleo.kicad_sch]
2025-09-27 iteration 2 routing
    [5V-Buck.kicad_sch, CAN_Sniffer_1.0.kicad_pcb, CAN_Sniffer_1.0.kicad_sch, CAN_transceiver1.kicad_sch, CLF7045NIT-330M-D.step, DDA0008J.stp, DDZ13B-7.stp, LDO.kicad_sch]
2026-01-09 sync changes
    [5V-Buck.kicad_sch, 693072010801.stp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]
