bruinformula/mk11-can-sniffer-pcb/(notices)

Notices in the files:
CAN_Sniffer_V2_/ECAD/USB1125-GF-B.stp:
author */ ('License CC BY-ND 4.0'),
